os4os-repo/ParKli_WaterQualitySensor/Arduino/Arduino_IDE_Board_Settings.PNG

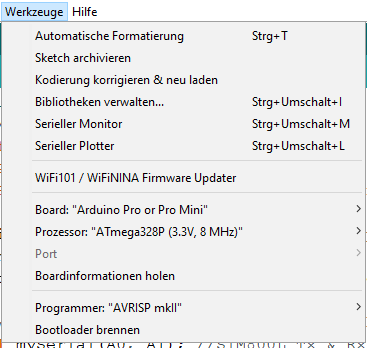
Arduino/Arduino_IDE_Board_Settings.PNG
