os4os-repo/ParKli_WaterQualitySensor/Images/PCB_WasserQualliSensor-V1.1.png

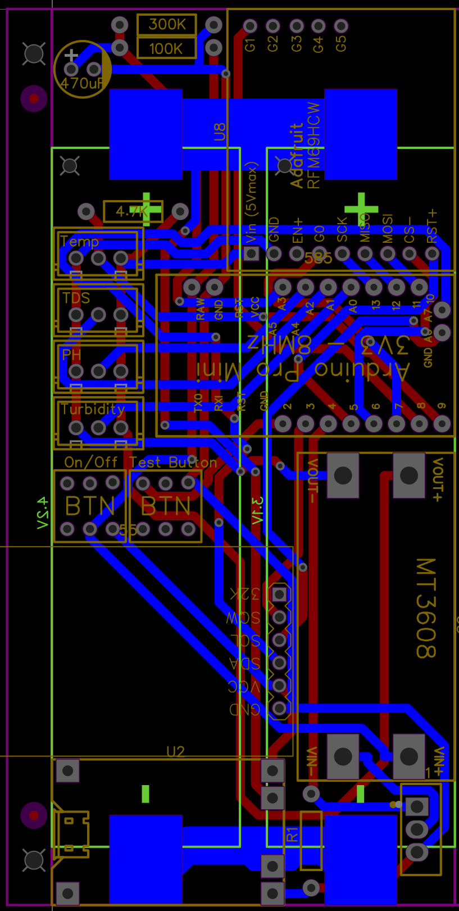
Images/PCB_WasserQualliSensor-V1.1.png
