os4os-repo/ParKli_WaterQualitySensor/Images/Schematic_WasserQualliSensor-V1.1.png

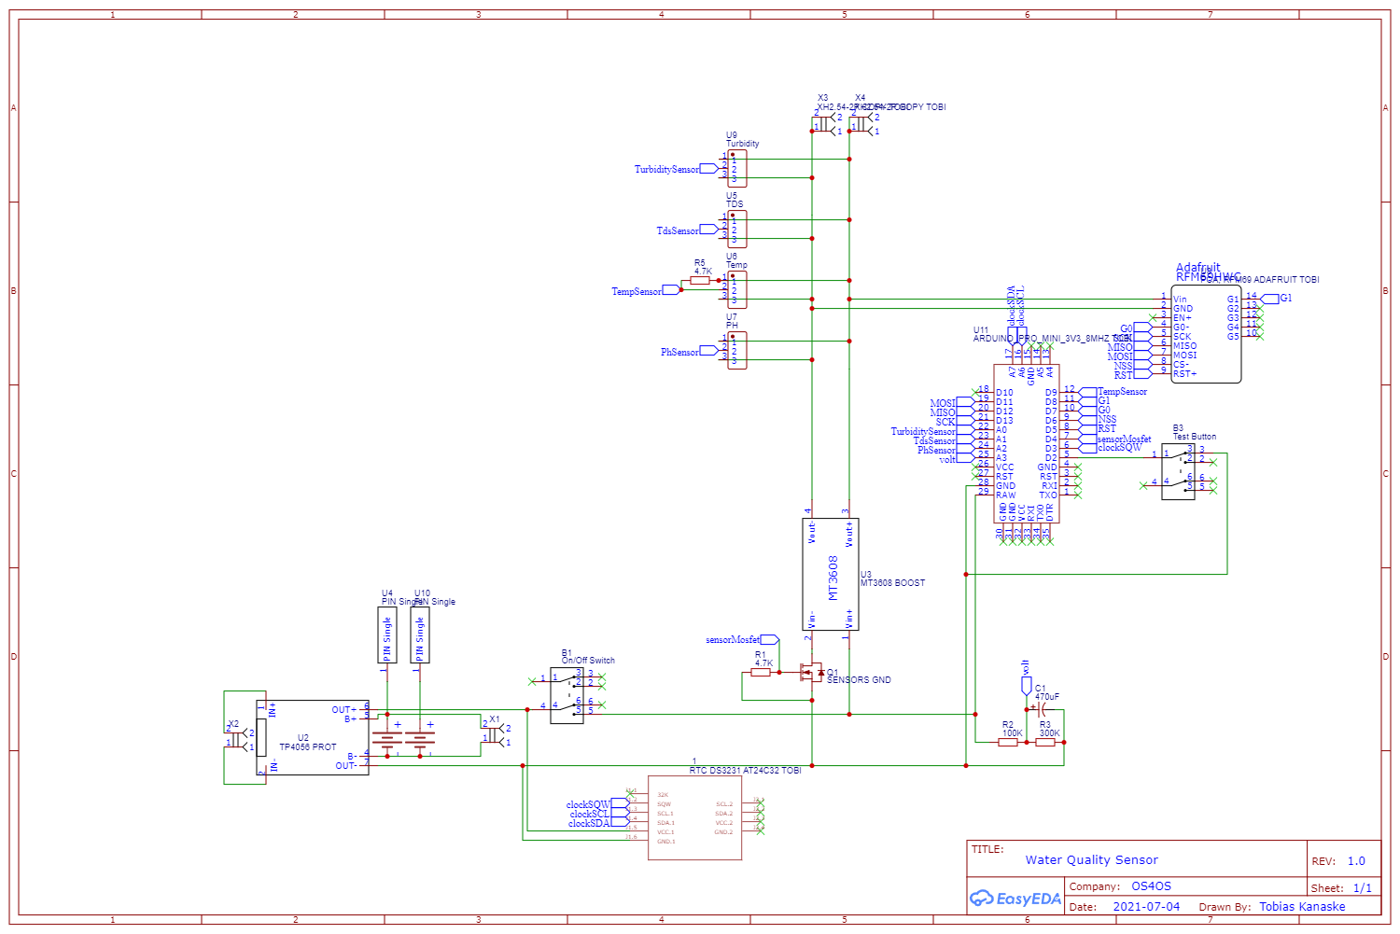
Images/Schematic_WasserQualliSensor-V1.1.png
