os4os-repo/ParKli_WaterQualitySensor/(list of files, drawings)

Other design files:
PcbResources/SCH_WasserQualliSensor V1.1_2022-12-06.json
